dwagner6/current-sensor/hardware/kicad_pulse_supply-rev-C/kicad_pulse_supply-rev-C.png

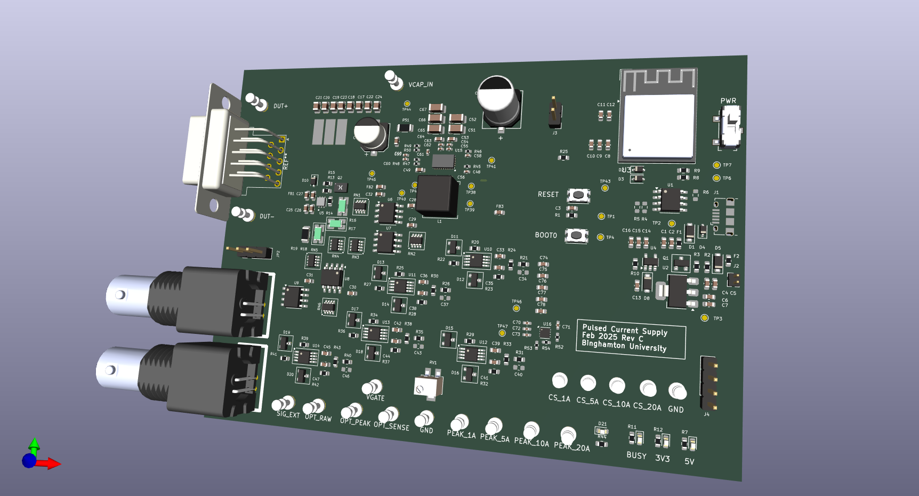
hardware/kicad_pulse_supply-rev-C/kicad_pulse_supply-rev-C.png
