dwagner6/current-sensor/flex_cable/pcbway_production/2024-09-23-13-44-39/flex_cable.kicad_pcb_bom.csv

designator | quantity | value | pack | mpn | mount_type
TP1, TP3 | 2 | V+ | TestPoint_Pad_4.0x4.0mm |  | tht
TP2, TP4 | 2 | V- | TestPoint_Pad_4.0x4.0mm |  | tht
