dwagner6/current-sensor/hardware/kicad components/A_DF_09_A_KG_T4S DSUB/A-DF_09_A_KG-T4S.step

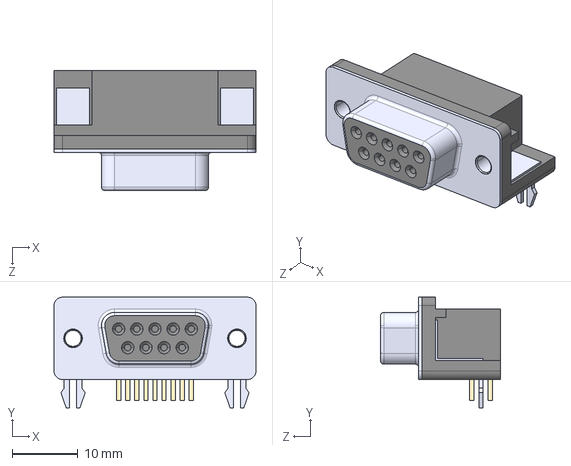
[picture p2: CAD file, 2025-02-28]
hardware/kicad components/A_DF_09_A_KG_T4S DSUB/A-DF_09_A_KG-T4S.step
30.8 x 16.9 x 18.3 mm
