dwagner6/current-sensor/hardware/current_sense_simulation/acs730.asc

C7: cap; 10n
C10: cap; 47µ
C11: cap; 47µ
C12: cap; 47µ
C13: cap; 47µ
C15: cap; 47µ
C17: cap; 1µ
C18: cap; 100n
C19: cap; 100n
D1: schottky; BAT17
D2: schottky; BAT17
D3: TVSdiode; SMBJ24CA
L2: ind; 1p
L3: ind; 1p
L4: ind; 5n
R1: res; 10m
R2: res; 8
R4: res; 1k
R5: res; 2.2k
R7: res; 22
R8: res; 1Meg
R9: res; 2
Rload1: res; 1
U2: GAN7R0-150LBE
U4: MAX4376T
U5: LTC6244
U6: LTC6244
U7: UCC27611_TRANS
V4: voltage; PULSE(0 3.3 0.5u 1n 3n 1u 1m)
V5: voltage; 12
V6: voltage; 3.3
V7: voltage; 5V
Named nets: 0, Vsense2, VDD, Vpeak, Vcap
.SUBCKT BAT17 1 2
R1 1 2 6E+07
D1 1 2 BAT17
*
.MODEL BAT17 D 
+ IS = 1.419E-09 
+ N = 1.022 
+ BV = 6 
+ IBV = 2.45E-06 
+ RS = 5.112 
+ CJO = 7.867E-13 
+ VJ = 0.1043 
+ M = 0.1439 
+ FC = 0.5 
+ TT = 0 
+ EG = 0.69 
+ XTI = 2 
.ENDS
.tran 4u
