dwagner6/current-sensor/labview/test_2J2QW_L3000.xlsx

vout | adc1 | raw1 | adc2 | raw2 | adc3 | raw3 | adc4 | raw4 | pwr | vout | adc4
800 | 47 | 142 | 236 | 142 | 473 | 142 | 946 | 142 | 0.096 | 800 | 946
850 | 47 | 142 | 236 | 142 | 473 | 142 | 946 | 142 | 0.096 | 850 | 946
900 | 47 | 142 | 236 | 142 | 473 | 142 | 946 | 142 | 0.096 | 900 | 946
950 | 47 | 142 | 236 | 142 | 473 | 142 | 946 | 142 | 0.096 | 950 | 946
1000 | 47 | 142 | 236 | 142 | 473 | 142 | 946 | 142 | 0.096 | 1000 | 946
1050 | 47 | 142 | 236 | 142 | 473 | 142 | 946 | 142 | 0.096 | 1050 | 946
1100 | 47 | 142 | 236 | 142 | 473 | 142 | 946 | 142 | 0.096 | 1100 | 946
1150 | 47 | 142 | 236 | 142 | 473 | 142 | 946 | 142 | 0.096 | 1150 | 946
1200 | 47 | 142 | 236 | 142 | 473 | 142 | 946 | 142 | 0.096 | 1200 | 946
1250 | 47 | 142 | 236 | 142 | 473 | 142 | 946 | 142 | 0.096 | 1250 | 946
1300 | 47 | 142 | 236 | 142 | 473 | 142 | 946 | 142 | 0.096 | 1300 | 946
1350 | 47 | 142 | 236 | 142 | 473 | 142 | 946 | 142 | 0.096 | 1350 | 946
1400 | 47 | 142 | 236 | 142 | 473 | 142 | 946 | 142 | 0.096 | 1400 | 946
1450 | 47 | 142 | 236 | 142 | 473 | 142 | 946 | 142 | 0.096 | 1450 | 946
1500 | 47 | 142 | 236 | 142 | 473 | 142 | 946 | 142 | 0.096 | 1500 | 946
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
