dwagner6/current-sensor/labview/test_2J3QW_L2000.xlsx

vout | adc1 | raw1 | adc2 | raw2 | adc3 | raw3 | adc4 | raw4 | pwr
800 | 47 | 142 | 236 | 142 | 473 | 142 | 946 | 142 | 0.096
850 | 47 | 142 | 236 | 142 | 473 | 142 | 946 | 142 | 0.096
900 | 47 | 142 | 236 | 142 | 473 | 142 | 946 | 142 | 0.096
950 | 47 | 142 | 236 | 142 | 473 | 142 | 946 | 142 | 0.096
1000 | 47 | 142 | 236 | 142 | 473 | 142 | 946 | 142 | 0.096
1050 | 47 | 142 | 236 | 142 | 473 | 142 | 946 | 142 | 0.096
1100 | 47 | 142 | 236 | 142 | 473 | 142 | 946 | 142 | 0.096
1150 | 47 | 142 | 236 | 142 | 473 | 142 | 946 | 142 | 0.096
1200 | 47 | 142 | 236 | 142 | 473 | 142 | 946 | 142 | 0.096
1250 | 47 | 142 | 236 | 142 | 473 | 142 | 946 | 142 | 0.096
1300 | 47 | 142 | 236 | 142 | 473 | 142 | 946 | 142 | 0.096
1350 | 47 | 142 | 236 | 142 | 473 | 142 | 946 | 142 | 0.096
1400 | 47 | 142 | 236 | 142 | 473 | 142 | 946 | 142 | 0.096
1450 | 47 | 142 | 236 | 142 | 473 | 142 | 946 | 142 | 0.096
1500 | 47 | 142 | 236 | 142 | 473 | 142 | 946 | 142 | 0.096
1550 | 47 | 142 | 236 | 142 | 473 | 142 | 946 | 142 | 0.096
1600 | 47 | 142 | 236 | 142 | 473 | 142 | 946 | 142 | 0.096
1650 | 47 | 142 | 236 | 142 | 473 | 142 | 946 | 142 | 0.096
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
