dwagner6/current-sensor/labview/opt_test_2J2QW_09202024.csv

vout | 1 amp |  | 5 amp |  | 10 amp |  | 20 amp |  | opt_pwr
800 | 143 | 429 | 236 | 142 | 473 | 142 | 946 | 142 | 0.03
820 | 47 | 142 | 236 | 142 | 473 | 142 | 946 | 142 | 0.03
840 | 47 | 142 | 236 | 142 | 473 | 142 | 946 | 142 | 0.03
860 | 47 | 142 | 236 | 142 | 473 | 142 | 946 | 142 | 0.03
880 | 47 | 142 | 236 | 142 | 473 | 142 | 946 | 142 | 0.03
900 | 47 | 142 | 236 | 142 | 473 | 142 | 946 | 142 | 0.03
920 | 47 | 142 | 236 | 142 | 473 | 142 | 946 | 142 | 0.03
940 | 47 | 142 | 236 | 142 | 473 | 142 | 946 | 142 | 0.03
960 | 47 | 142 | 236 | 142 | 473 | 142 | 946 | 142 | 0.03
980 | 47 | 142 | 236 | 142 | 473 | 142 | 946 | 142 | 0.03
1000 | 47 | 142 | 236 | 142 | 473 | 142 | 946 | 142 | 0.03
1020 | 47 | 142 | 236 | 142 | 473 | 142 | 946 | 142 | 0.03
1040 | 47 | 142 | 236 | 142 | 473 | 142 | 946 | 142 | 0.03
1060 | 47 | 142 | 236 | 142 | 473 | 142 | 946 | 142 | 0.03
1080 | 47 | 142 | 236 | 142 | 473 | 142 | 946 | 142 | 0.03
1100 | 47 | 142 | 236 | 142 | 473 | 142 | 946 | 142 | 0.03
1120 | 47 | 142 | 236 | 142 | 473 | 142 | 946 | 142 | 0.03
1140 | 47 | 142 | 236 | 142 | 473 | 142 | 946 | 142 | 0.03
1160 | 47 | 142 | 236 | 142 | 473 | 142 | 946 | 142 | 0.03
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
