dwagner6/current-sensor/labview/test_09132024_250_mohm.csv

vout | 1 Amp | raw1 | 5 Amp | raw2 | 10 Amp | raw3 | 20 Amp | raw4
800 | 862 | 2586 | 1121 | 673 | 473 | 142 | 946 | 142
820 | 861 | 2583 | 1120 | 672 | 473 | 142 | 946 | 142
840 | 859 | 2578 | 1150 | 690 | 510 | 153 | 946 | 142
860 | 858 | 2574 | 1178 | 707 | 660 | 198 | 946 | 142
880 | 854 | 2564 | 1208 | 725 | 776 | 233 | 946 | 142
900 | 849 | 2547 | 1238 | 743 | 906 | 272 | 946 | 142
920 | 843 | 2529 | 1266 | 760 | 1000 | 300 | 946 | 142
940 | 834 | 2504 | 1295 | 777 | 1106 | 332 | 946 | 142
960 | 823 | 2471 | 1325 | 795 | 1170 | 351 | 946 | 142
980 | 813 | 2440 | 1353 | 812 | 1230 | 369 | 946 | 142
1000 | 801 | 2404 | 1381 | 829 | 1263 | 379 | 946 | 142
1020 | 792 | 2378 | 1411 | 847 | 1296 | 389 | 946 | 142
1040 | 788 | 2364 | 1440 | 864 | 1323 | 397 | 946 | 142
1060 | 842 | 2527 | 1471 | 883 | 1360 | 408 | 946 | 142
1080 | 845 | 2537 | 1503 | 902 | 1393 | 418 | 946 | 142
1100 | 845 | 2535 | 1535 | 921 | 1426 | 428 | 946 | 142
1120 | 843 | 2531 | 1568 | 941 | 1460 | 438 | 946 | 142
1140 | 841 | 2524 | 1600 | 960 | 1490 | 447 | 946 | 142
1160 | 839 | 2517 | 1631 | 979 | 1523 | 457 | 946 | 142
1180 | 838 | 2515 | 1666 | 1000 | 1560 | 468 | 946 | 142
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
