dwagner6/current-sensor/labview/test_09132025_short.csv

vout | adc1 | raw1 | adc2 | raw2 | adc3 | raw3 | adc4 | raw4
800 | 47 | 142 | 236 | 142 | 473 | 142 | 946 | 142
800 | 47 | 142 | 236 | 142 | 473 | 142 | 946 | 142
810 | 836 | 2509 | 1371 | 823 | 473 | 142 | 946 | 142
820 | 831 | 2495 | 1411 | 847 | 473 | 142 | 946 | 142
830 | 826 | 2480 | 1443 | 866 | 473 | 142 | 946 | 142
840 | 822 | 2466 | 1471 | 883 | 473 | 142 | 946 | 142
850 | 817 | 2452 | 1498 | 899 | 473 | 142 | 946 | 142
860 | 812 | 2438 | 1521 | 913 | 473 | 142 | 946 | 142
870 | 808 | 2424 | 1533 | 920 | 473 | 142 | 946 | 142
880 | 802 | 2408 | 1551 | 931 | 473 | 142 | 946 | 142
890 | 798 | 2394 | 1568 | 941 | 473 | 142 | 946 | 142
900 | 794 | 2383 | 1581 | 949 | 473 | 142 | 946 | 142
910 | 790 | 2371 | 1596 | 958 | 473 | 142 | 946 | 142
920 | 786 | 2360 | 1615 | 969 | 473 | 142 | 946 | 142
930 | 786 | 2360 | 1628 | 977 | 513 | 154 | 946 | 142
940 | 801 | 2404 | 1655 | 993 | 610 | 183 | 946 | 142
950 | 841 | 2525 | 1665 | 999 | 683 | 205 | 946 | 142
960 | 845 | 2535 | 1685 | 1011 | 736 | 221 | 946 | 142
970 | 846 | 2538 | 1700 | 1020 | 786 | 236 | 946 | 142
980 | 846 | 2539 | 1716 | 1030 | 886 | 266 | 946 | 142
990 | 845 | 2537 | 1728 | 1037 | 976 | 293 | 946 | 142
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
