dwagner6/current-sensor/hardware/difference_amp_breakout/gerber_to_order/diff_amp_breakout_44.5x25.0mm_for_Elecrow/diff_amp_breakout-NPTH.TXT

M48
; DRILL file {KiCad 8.0.1} date 2025-02-04T12:10:19-0500
; FORMAT={-:-/ absolute / metric / decimal}
; #@! TF.CreationDate,2025-02-04T12:10:19-05:00
; #@! TF.GenerationSoftware,Kicad,Pcbnew,8.0.1
; #@! TF.FileFunction,NonPlated,1,2,NPTH
FMAT,2
METRIC
%
G90
G05
M30
