dwagner6/current-sensor/(commit log)

2024-05-14 Last changes before working on ADC code
2024-05-14 Began implementing 4 ADC channels and moved project to Arduino-ESP32 2.0.16 for new ADC functions
2024-05-14 Moved platform again to alpha version of Arduino-ESP32 and esp-idf v5.1
2024-05-14 Implemented ADC channels in continuous mode using latest Arduino-ESP32 framework functions
2024-05-26 Basic current regulating implemented
2024-08-19 Initial commit
    Initial commit. Rebasing project to run on control of capacitor voltage Vout and removing current-based control
2024-08-22 Moving frequency control to ESP32-Arduino library
2024-08-22 Refactored code to use sscanf instead of strtok (not threadsafe)
2024-08-22 Fixed annoying frequency control issue
    [main.cpp]
2024-08-29 Added adc reading function and updated command reference
2024-09-05 added raw_adc command to read adc millivolts
2024-09-05 Big revision to labview vi: settings are read and displayed automatically, adc readings are shown
2024-09-05 Added raw adc voltage readings to labview
2024-09-12 Refactored main loop to use Arduino Strings
    [buck-boost.kicad_sch, esp32.kicad_sch, fet_and_driver.kicad_sch, kicad_pulse_supply-rev-C.kicad_sch, peak_detect.kicad_sch]
2024-09-19 Starting to add optical power ADC reading
    [test_09132024_250_mohm.csv, test_09132025_short.csv, test_09162024.csv, test_09162024_250_mohm.csv]
2024-11-07 firmware complete for compliance voltage mode
    [flex_cable.kicad_pcb, flex_cable.kicad_pcb_bom.csv, flex_cable.kicad_pcb_positions.csv, flex_cable.kicad_sch, opt_test_09202024.csv, opt_test_2J2QW_09202024.csv, opt_test_2J2QW_09202024.xlsx, sweep_09262024_1J3QW_W100.csv]
2025-02-07 hardware breakout boards added, pcb rev-c began
    [buck-boost.kicad_sch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]
2025-02-07 added kicad project backups to .gitignore
2025-02-28 Rev C pcb complete, last commit before branching firmware for new board
    [A-DF_09_A_KG-T4S.step, T-B5W519245A-3sets-cc_laser_supply_rev-B.kicad_pcb_bom(2024-01-31).xls, bom.csv, cc_laser_supply_rev-B.kicad_pcb_bom.csv, cc_laser_supply_rev-B.kicad_pcb_positions.csv, curr_sense.kicad_sch, designators.csv, diff_amp_breakout.kicad_sch]
